Cylopsis/Little-TempControled-Box/assets/circuit.png

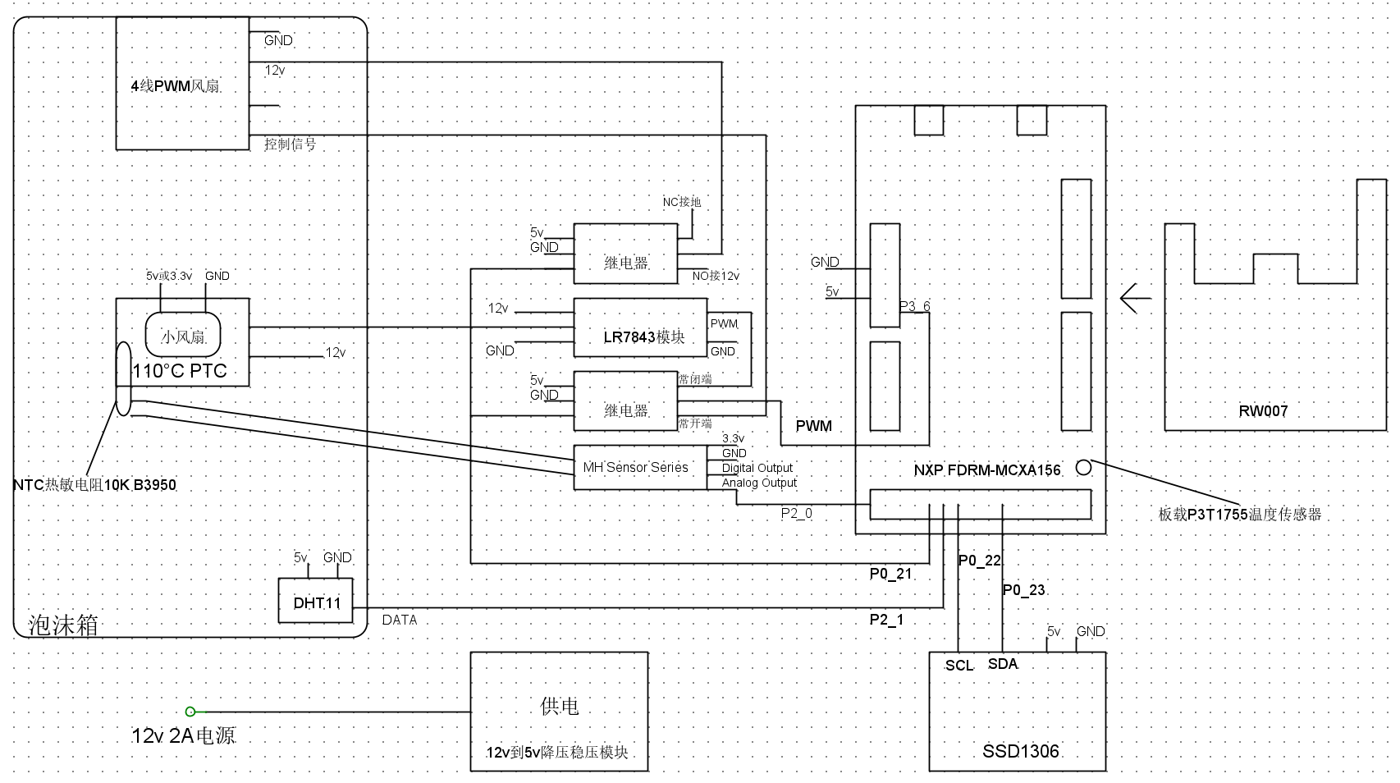
assets/circuit.png
