Cylopsis/Little-TempControled-Box/assets/hardware2.jpg

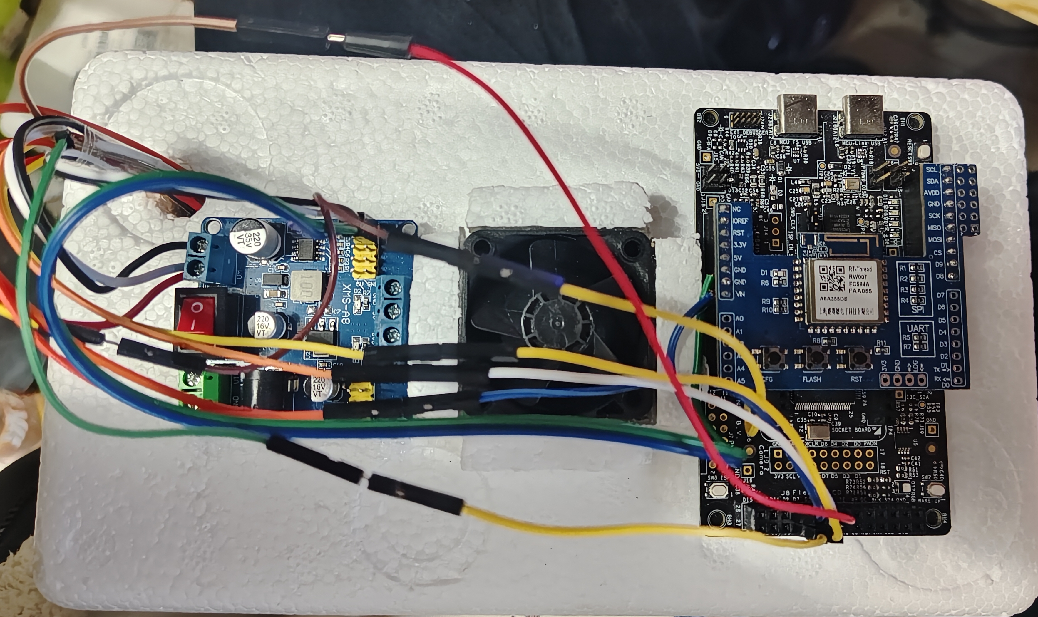
assets/hardware2.jpg
