Cylopsis/Little-TempControled-Box/rtconfig.h

#ifndef RT_CONFIG_H__
#define RT_CONFIG_H__

#define SOC_MCX

/* RT-Thread Kernel */

/* klibc options */

/* rt_vsnprintf options */

#define RT_KLIBC_USING_VSNPRINTF_LONGLONG
#define RT_KLIBC_USING_VSNPRINTF_STANDARD
#define RT_KLIBC_USING_VSNPRINTF_DECIMAL_SPECIFIERS
#define RT_KLIBC_USING_VSNPRINTF_EXPONENTIAL_SPECIFIERS
#define RT_KLIBC_USING_VSNPRINTF_WRITEBACK_SPECIFIER
#define RT_KLIBC_USING_VSNPRINTF_CHECK_NUL_IN_FORMAT_SPECIFIER
#define RT_KLIBC_USING_VSNPRINTF_INTEGER_BUFFER_SIZE 32
#define RT_KLIBC_USING_VSNPRINTF_DECIMAL_BUFFER_SIZE 32
#define RT_KLIBC_USING_VSNPRINTF_FLOAT_PRECISION 6
#define RT_KLIBC_USING_VSNPRINTF_MAX_INTEGRAL_DIGITS_FOR_DECIMAL 9
#define RT_KLIBC_USING_VSNPRINTF_LOG10_TAYLOR_TERMS 4
/* end of rt_vsnprintf options */

/* rt_vsscanf options */

/* end of rt_vsscanf options */

/* rt_memset options */

/* end of rt_memset options */

/* rt_memcpy options */

/* end of rt_memcpy options */

/* rt_memmove options */

/* end of rt_memmove options */

/* rt_memcmp options */

/* end of rt_memcmp options */

/* rt_strstr options */

/* end of rt_strstr options */

/* rt_strcasecmp options */

/* end of rt_strcasecmp options */

/* rt_strncpy options */

/* end of rt_strncpy options */

/* rt_strcpy options */

/* end of rt_strcpy options */

/* rt_strncmp options */

/* end of rt_strncmp options */

/* rt_strcmp options */

/* end of rt_strcmp options */

/* rt_strlen options */

/* end of rt_strlen options */

/* rt_strnlen options */

/* end of rt_strnlen options */
/* end of klibc options */
#define RT_NAME_MAX 16
#define RT_CPUS_NR 1
#define RT_ALIGN_SIZE 8
#define RT_THREAD_PRIORITY_32
#define RT_THREAD_PRIORITY_MAX 32
#define RT_TICK_PER_SECOND 1000
#define RT_USING_OVERFLOW_CHECK
#define RT_USING_HOOK
#define RT_HOOK_USING_FUNC_PTR
#define RT_USING_IDLE_HOOK
#define RT_IDLE_HOOK_LIST_SIZE 4
#define IDLE_THREAD_STACK_SIZE 512
#define RT_USING_TIMER_SOFT
#define RT_TIMER_THREAD_PRIO 4
#define RT_TIMER_THREAD_STACK_SIZE 1024

/* kservice options */

/* end of kservice options */
#define RT_USING_DEBUG
#define RT_DEBUGING_ASSERT
#define RT_DEBUGING_COLOR
#define RT_DEBUGING_CONTEXT

/* Inter-Thread communication */

#define RT_USING_SEMAPHORE
#define RT_USING_MUTEX
#define RT_USING_EVENT
#define RT_USING_MAILBOX
#define RT_USING_MESSAGEQUEUE
/* end of Inter-Thread communication */

/* Memory Management */

#define RT_USING_MEMPOOL
#define RT_USING_SMALL_MEM
#define RT_USING_SMALL_MEM_AS_HEAP
#define RT_USING_HEAP
/* end of Memory Management */
#define RT_USING_DEVICE
#define RT_USING_CONSOLE
#define RT_CONSOLEBUF_SIZE 128
#define RT_CONSOLE_DEVICE_NAME "uart0"
#define RT_VER_NUM 0x50201
#define RT_BACKTRACE_LEVEL_MAX_NR 32
/* end of RT-Thread Kernel */
#define RT_USING_HW_ATOMIC
#define RT_USING_CPU_FFS
#define ARCH_ARM
#define ARCH_ARM_CORTEX_M
#define ARCH_ARM_CORTEX_FPU
#define ARCH_ARM_CORTEX_M33

/* RT-Thread Components */

#define RT_USING_COMPONENTS_INIT
#define RT_USING_USER_MAIN
#define RT_MAIN_THREAD_STACK_SIZE 2048
#define RT_MAIN_THREAD_PRIORITY 10
#define RT_USING_MSH
#define RT_USING_FINSH
#define FINSH_USING_MSH
#define FINSH_THREAD_NAME "LittlePipu"
#define FINSH_THREAD_PRIORITY 20
#define FINSH_THREAD_STACK_SIZE 2048
#define FINSH_USING_HISTORY
#define FINSH_HISTORY_LINES 5
#define FINSH_USING_SYMTAB
#define FINSH_CMD_SIZE 80
#define MSH_USING_BUILT_IN_COMMANDS
#define FINSH_USING_DESCRIPTION
#define FINSH_ARG_MAX 10
#define FINSH_USING_OPTION_COMPLETION

/* DFS: device virtual file system */

/* end of DFS: device virtual file system */

/* Device Drivers */

#define RT_USING_DEVICE_IPC
#define RT_UNAMED_PIPE_NUMBER 64
#define RT_USING_SYSTEM_WORKQUEUE
#define RT_SYSTEM_WORKQUEUE_STACKSIZE 2048
#define RT_SYSTEM_WORKQUEUE_PRIORITY 23
#define RT_USING_SERIAL
#define RT_USING_SERIAL_V1
#define RT_SERIAL_USING_DMA
#define RT_SERIAL_RB_BUFSZ 64
#define RT_USING_I2C
#define RT_I2C_DEBUG
#define RT_USING_I2C_BITOPS
#define RT_USING_SOFT_I2C
#define RT_USING_SOFT_I2C1
#define RT_SOFT_I2C1_SCL_PIN 22
#define RT_SOFT_I2C1_SDA_PIN 23
#define RT_SOFT_I2C1_BUS_NAME "i2c1"
#define RT_SOFT_I2C1_TIMING_DELAY 10
#define RT_SOFT_I2C1_TIMING_TIMEOUT 10
#define RT_USING_ADC
#define RT_USING_PWM
#define RT_USING_SPI
#define RT_USING_SENSOR
#define RT_USING_SENSOR_CMD
#define RT_USING_WIFI
#define RT_WLAN_DEVICE_STA_NAME "wlan0"
#define RT_WLAN_DEVICE_AP_NAME "wlan1"
#define RT_WLAN_SSID_MAX_LENGTH 32
#define RT_WLAN_PASSWORD_MAX_LENGTH 32
#define RT_WLAN_DEV_EVENT_NUM 2
#define RT_WLAN_MANAGE_ENABLE
#define RT_WLAN_SCAN_WAIT_MS 10000
#define RT_WLAN_CONNECT_WAIT_MS 10000
#define RT_WLAN_SCAN_SORT
#define RT_WLAN_MSH_CMD_ENABLE
#define RT_WLAN_JOIN_SCAN_BY_MGNT
#define RT_WLAN_AUTO_CONNECT_ENABLE
#define AUTO_CONNECTION_PERIOD_MS 2000
#define RT_WLAN_CFG_ENABLE
#define RT_WLAN_CFG_INFO_MAX 3
#define RT_WLAN_PROT_ENABLE
#define RT_WLAN_PROT_NAME_LEN 8
#define RT_WLAN_PROT_MAX 2
#define RT_WLAN_DEFAULT_PROT "lwip"
#define RT_WLAN_PROT_LWIP_ENABLE
#define RT_WLAN_PROT_LWIP_NAME "lwip"
#define RT_WLAN_WORK_THREAD_ENABLE
#define RT_WLAN_WORKQUEUE_THREAD_NAME "wlan"
#define RT_WLAN_WORKQUEUE_THREAD_SIZE 2048
#define RT_WLAN_WORKQUEUE_THREAD_PRIO 15
#define RT_USING_PIN
#define RT_USING_HWTIMER
/* end of Device Drivers */

/* C/C++ and POSIX layer */

/* ISO-ANSI C layer */

/* Timezone and Daylight Saving Time */

#define RT_LIBC_USING_LIGHT_TZ_DST
#define RT_LIBC_TZ_DEFAULT_HOUR 8
#define RT_LIBC_TZ_DEFAULT_MIN 0
#define RT_LIBC_TZ_DEFAULT_SEC 0
/* end of Timezone and Daylight Saving Time */
/* end of ISO-ANSI C layer */

/* POSIX (Portable Operating System Interface) layer */


/* Interprocess Communication (IPC) */


/* Socket is in the 'Network' category */

/* end of Interprocess Communication (IPC) */
/* end of POSIX (Portable Operating System Interface) layer */
/* end of C/C++ and POSIX layer */

/* Network */

#define RT_USING_SAL
#define SAL_INTERNET_CHECK

/* Docking with protocol stacks */

#define SAL_USING_LWIP
/* end of Docking with protocol stacks */
#define SAL_SOCKETS_NUM 16
#define RT_USING_NETDEV
#define NETDEV_USING_IFCONFIG
#define NETDEV_USING_PING
#define NETDEV_USING_NETSTAT
#define NETDEV_USING_AUTO_DEFAULT
#define NETDEV_IPV4 1
#define NETDEV_IPV6 0
#define RT_USING_LWIP
#define RT_USING_LWIP203
#define RT_USING_LWIP_VER_NUM 0x20003
#define RT_LWIP_MEM_ALIGNMENT 4
#define RT_LWIP_IGMP
#define RT_LWIP_ICMP
#define RT_LWIP_DNS
#define RT_LWIP_DHCP
#define IP_SOF_BROADCAST 1
#define IP_SOF_BROADCAST_RECV 1

/* Static IPv4 Address */

#define RT_LWIP_IPADDR "192.168.1.30"
#define RT_LWIP_GWADDR "192.168.1.1"
#define RT_LWIP_MSKADDR "255.255.255.0"
/* end of Static IPv4 Address */
#define RT_LWIP_UDP
#define RT_LWIP_TCP
#define RT_LWIP_RAW
#define RT_MEMP_NUM_NETCONN 8
#define RT_LWIP_PBUF_NUM 16
#define RT_LWIP_RAW_PCB_NUM 4
#define RT_LWIP_UDP_PCB_NUM 4
#define RT_LWIP_TCP_PCB_NUM 4
#define RT_LWIP_TCP_SEG_NUM 40
#define RT_LWIP_TCP_SND_BUF 8196
#define RT_LWIP_TCP_WND 8196
#define RT_LWIP_TCPTHREAD_PRIORITY 10
#define RT_LWIP_TCPTHREAD_MBOX_SIZE 8
#define RT_LWIP_TCPTHREAD_STACKSIZE 4096
#define RT_LWIP_ETHTHREAD_PRIORITY 12
#define RT_LWIP_ETHTHREAD_STACKSIZE 1024
#define RT_LWIP_ETHTHREAD_MBOX_SIZE 8
#define LWIP_NETIF_STATUS_CALLBACK 1
#define LWIP_NETIF_LINK_CALLBACK 1
#define RT_LWIP_NETIF_NAMESIZE 6
#define SO_REUSE 1
#define LWIP_SO_RCVTIMEO 1
#define LWIP_SO_SNDTIMEO 1
#define LWIP_SO_RCVBUF 1
#define LWIP_SO_LINGER 0
#define LWIP_NETIF_LOOPBACK 0
#define RT_LWIP_USING_PING
/* end of Network */

/* Memory protection */

/* end of Memory protection */

/* Utilities */

#define RT_USING_ULOG
#define ULOG_OUTPUT_LVL_I
#define ULOG_OUTPUT_LVL 6
#define ULOG_USING_ISR_LOG
#define ULOG_ASSERT_ENABLE
#define ULOG_LINE_BUF_SIZE 128

/* log format */

#define ULOG_OUTPUT_FLOAT
#define ULOG_OUTPUT_LEVEL
#define ULOG_OUTPUT_TAG
/* end of log format */
#define ULOG_BACKEND_USING_CONSOLE
/* end of Utilities */

/* Using USB legacy version */

/* end of Using USB legacy version */
/* end of RT-Thread Components */

/* RT-Thread Utestcases */

/* end of RT-Thread Utestcases */

/* RT-Thread online packages */

/* IoT - internet of things */

#define PKG_USING_WEBCLIENT
#define WEBCLIENT_USING_SAMPLES
#define WEBCLIENT_NOT_USE_TLS
#define PKG_USING_WEBCLIENT_V220
#define PKG_WEBCLIENT_VER_NUM 0x20200

/* Wi-Fi */

/* Marvell WiFi */

/* end of Marvell WiFi */

/* Wiced WiFi */

/* end of Wiced WiFi */
#define PKG_USING_RW007
#define PKG_USING_RW007_V210
#define RW007_NOT_USE_EXAMPLE_DRIVERS
#define RW007_SPI_MAX_HZ 30000000

/* CYW43012 WiFi */

/* end of CYW43012 WiFi */

/* BL808 WiFi */

/* end of BL808 WiFi */

/* CYW43439 WiFi */

/* end of CYW43439 WiFi */
/* end of Wi-Fi */

/* IoT Cloud */

/* end of IoT Cloud */
/* end of IoT - internet of things */

/* security packages */

/* end of security packages */

/* language packages */

/* JSON: JavaScript Object Notation, a lightweight data-interchange format */

#define PKG_USING_CJSON
#define PKG_USING_CJSON_V1717
/* end of JSON: JavaScript Object Notation, a lightweight data-interchange format */

/* XML: Extensible Markup Language */

/* end of XML: Extensible Markup Language */
/* end of language packages */

/* multimedia packages */

/* LVGL: powerful and easy-to-use embedded GUI library */

/* end of LVGL: powerful and easy-to-use embedded GUI library */

/* u8g2: a monochrome graphic library */

#define PKG_USING_U8G2_OFFICIAL

/* U8G2 Examples */

#define U8G2_USING_SW_I2C_SSD1306
/* end of U8G2 Examples */
#define PKG_USING_U8G2_OFFICIAL_LATEST_VERSION
#define PKG_U8G2_OFFICIAL_VER_NUM 0x99999
/* end of u8g2: a monochrome graphic library */
/* end of multimedia packages */

/* tools packages */

/* end of tools packages */

/* system packages */

/* enhanced kernel services */

/* end of enhanced kernel services */

/* acceleration: Assembly language or algorithmic acceleration packages */

/* end of acceleration: Assembly language or algorithmic acceleration packages */

/* CMSIS: ARM Cortex-M Microcontroller Software Interface Standard */

/* end of CMSIS: ARM Cortex-M Microcontroller Software Interface Standard */

/* Micrium: Micrium software products porting for RT-Thread */

/* end of Micrium: Micrium software products porting for RT-Thread */
/* end of system packages */

/* peripheral libraries and drivers */

/* HAL & SDK Drivers */

/* STM32 HAL & SDK Drivers */

/* end of STM32 HAL & SDK Drivers */

/* Infineon HAL Packages */

/* end of Infineon HAL Packages */

/* Kendryte SDK */

/* end of Kendryte SDK */

/* WCH HAL & SDK Drivers */

/* end of WCH HAL & SDK Drivers */

/* AT32 HAL & SDK Drivers */

/* end of AT32 HAL & SDK Drivers */

/* HC32 DDL Drivers */

/* end of HC32 DDL Drivers */

/* NXP HAL & SDK Drivers */

#define PKG_USING_NXP_MCX_CMSIS_DRIVER
#define PKG_USING_NXP_MCX_CMSIS_DRIVER_LATEST_VERSION
#define PKG_USING_NXP_MCX_SERIES_DRIVER
#define PKG_USING_NXP_MCX_SERIES_DRIVER_LATEST_VERSION
/* end of NXP HAL & SDK Drivers */

/* NUVOTON Drivers */

/* end of NUVOTON Drivers */

/* GD32 Drivers */

/* end of GD32 Drivers */
/* end of HAL & SDK Drivers */

/* sensors drivers */

#define PKG_USING_DHTXX
#define PKG_USING_DHTXX_TYPE_DHT11
#define PKG_DHTXX_USING_SENSOR_V1
#define PKG_USING_DHTXX_SAMPLE_SENSOR_V1
#define PKG_USING_DHTXX_DEBUG
#define PKG_USING_DHTXX_LATEST_VERSION
#define PKG_DHTXX_VER_NUM 0x99999
#define PKG_USING_P3T1755
#define P3T1755_I2C_BUS_NAME "i2c0"
#define PKG_USING_P3T1755_LATEST_VERSION
/* end of sensors drivers */

/* touch drivers */

/* end of touch drivers */
#define PKG_USING_I2C_TOOLS
#define PKG_USING_I2C_TOOLS_LATEST_VERSION
#define PKG_USING_SSD1306
#define PKG_USING_SSD1306_DEBUG
#define PKG_USING_SSD1306_I2C_ADDRESS 0x3C
#define PKG_USING_SSD1306_I2C_BUS_NAME "i2c2"
#define PKG_USING_SSD1306_SAMPLE
#define PKG_USING_SSD1306_LATEST_VERSION
/* end of peripheral libraries and drivers */

/* AI packages */

/* end of AI packages */

/* Signal Processing and Control Algorithm Packages */

/* end of Signal Processing and Control Algorithm Packages */

/* miscellaneous packages */

/* project laboratory */

/* end of project laboratory */

/* samples: kernel and components samples */

#define PKG_USING_NETWORK_SAMPLES
#define PKG_USING_NETWORK_SAMPLES_LATEST_VERSION
#define NETWORK_SAMPLES_USING_TCP_SERVER
/* end of samples: kernel and components samples */

/* entertainment: terminal games and other interesting software packages */

/* end of entertainment: terminal games and other interesting software packages */
/* end of miscellaneous packages */

/* Arduino libraries */


/* Projects and Demos */

/* end of Projects and Demos */

/* Sensors */

/* end of Sensors */

/* Display */

/* end of Display */

/* Timing */

/* end of Timing */

/* Data Processing */

/* end of Data Processing */

/* Data Storage */

/* Communication */

/* end of Communication */

/* Device Control */

/* end of Device Control */

/* Other */

/* end of Other */

/* Signal IO */

/* end of Signal IO */

/* Uncategorized */

/* end of Arduino libraries */
/* end of RT-Thread online packages */

/* Hardware Drivers Config */

#define SOC_MCXA156

/* On-chip Peripheral Drivers */

#define BSP_USING_PIN
#define BSP_USING_UART
#define BSP_USING_UART0
#define BSP_USING_I2C
#define BSP_USING_I2C0
#define BSP_USING_SPI
#define BSP_USING_SPI1
#define BSP_USING_ADC
#define BSP_USING_ADC0_CH0
#define BSP_USING_PWM
#define BSP_USING_PWM0
#define BSP_USING_PWM1
/* end of On-chip Peripheral Drivers */

/* Board extended module Drivers */

#define BSP_USING_RW007
#define BOARD_RW007_SPI_BUS_NAME "spi1"
#define BOARD_RW007_CS_PIN 0x46
#define BOARD_RW007_INT_BUSY_PIN 0x71
#define BOARD_RW007_RST_PIN 0x2F
#define BSP_USING_P3T1755
/* end of Board extended module Drivers */
/* end of Hardware Drivers Config */

/* Application Configuration */

/* Fan Configuration */

#define PKG_USING_YS4028B12H
#define PKG_USING_YS4028B12H_PWM_DEV_NAME "pwm0"
#define PKG_USING_YS4028B12H_PWM_CHANNEL 0
#define PKG_USING_YS4028B12H_PERIOD 40000
#define PKG_USING_YS4028B12H_DEFAULT_PAULSE 10000
/* end of Fan Configuration */

/* MOS-PTC Configuration */

#define APP_PTC_PWM_DEV_NAME "pwm0"
#define APP_PTC_PWM_CHANNEL 0
#define APP_PTC_FREQUENCY 2000
#define PTC_MAX_SAFE_TEMP 110
/* end of MOS-PTC Configuration */

/* WLAN Configuration */

#define APP_WLAN_SSID "142A_SecurityPlus"
#define APP_WLAN_PASSWORD "142a8888"
/* end of WLAN Configuration */
/* end of Application Configuration */

#endif
