Cylopsis/Little-TempControled-Box/(commit log)

2025-11-09 Initial Commit：初步完成温控
2025-11-10 添加前端测试
2025-11-10 优化前端界面
2025-11-11 优化温控逻辑
2025-11-11 添加历史数据
2025-11-18 优化状态转移 在前端绘制四条状态转移界限线
2025-11-18 添加README
2025-11-24 温控优化：使用PID结合MOS管控制PTC发热片温度以更精确简单地控制箱内温度
2025-11-24 更新网页前端
2025-11-24 更新README
2025-11-26 添加 PTC 和 WLAN 图片资源
2025-11-27 添加项目概述文档，新增电路图和硬件图片资源
